yosihisa/EDAMAMEv3/PCB/EDAMAMEv3.kicad_pcb

## KiCad design PCB/EDAMAMEv3.kicad_pcb (2019-02-07)

Schematic: EDAMAMEv3.sch, EDAMAME v3

Parts:
C1, C3, C4, C7, C9, C11, C12, C13, C14: 0.1u; C_0603_1608Metric_Pad1.05x0.95mm_HandSolder
C2, C5: 2.2u; C_0603_1608Metric_Pad1.05x0.95mm_HandSolder
C6, C10: 1u; C_0603_1608Metric_Pad1.05x0.95mm_HandSolder
C8, C15, C16: 10u; C_0805_2012Metric_Pad1.15x1.40mm_HandSolder
D1, D2, D3, D4, D5: LED; LED_0603_1608Metric_Pad1.05x0.95mm_HandSolder
J1: BOOT0; SolderJumper-2_P1.3mm_Open_RoundedPad1.0x1.5mm
J2: Debug; STlink
J3: FLIGHT_PIN; PinHeader_1x02_P2.54mm_Horizontal
J4: WiFi; ZUNDA_WIRELESS
J5: C1098; Pin_Header_Straight_1x04_Pitch2.00mm
P1: LiPo1; JST_EH_S02B-EH_1x02_P2.50mm_Horizontal
P2: LiPo2; JST_EH_S02B-EH_1x02_P2.50mm_Horizontal
P3: CHARGE; JST_EH_B03B-EH-A_1x03_P2.50mm_Vertical
P4: MOTOR_R; JST_EH_B02B-EH-A_1x02_P2.50mm_Vertical
P5: MOTOR_L; JST_EH_B02B-EH-A_1x02_P2.50mm_Vertical
P6: NICHROME; TerminalBlock_MetzConnect_Type101_RT01602HBWC_1x02_P5.08mm_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
Q1: 2SC2712; SOT-23
Q2: FDS4675; SOIC-8_3.9x4.9mm_P1.27mm
R1, R3: 10; R_0603_1608Metric_Pad1.05x0.95mm_HandSolder
R2: 10m; R_2512_6332Metric_Pad1.52x3.35mm_HandSolder
R4, R5, R6, R7, R19: 1k; R_0603_1608Metric_Pad1.05x0.95mm_HandSolder
R8, R18: 10k; R_0603_1608Metric_Pad1.05x0.95mm_HandSolder
R9, R10: 2.2k; R_0603_1608Metric_Pad1.05x0.95mm_HandSolder
R11: 47; R_0603_1608Metric_Pad1.05x0.95mm_HandSolder
R12, R13, R14, R15, R16: 22K; R_0603_1608Metric_Pad1.05x0.95mm_HandSolder
R17: 100; R_0603_1608Metric_Pad1.05x0.95mm_HandSolder
SW1: POWER; SS-12D01-VG4
U1: ADP3338AKCZ-3.3; SOT-223-3_TabPin2
U2: MCP1703AT-3302E/CB; SOT-23
U3: STM32F767VITx; LQFP-100_14x14mm_P0.5mm
U4: INA226; MSOP-10_3x3mm_P0.5mm
U5: MPU-9250; QFN-24_3x3mm_P0.4mm
U6: GYSFDMAXB
U7: microSD; microSD_HC_Hirose_DM3AT-SF-PEJM5
U8, U9: BD6231F; SOIC-8_3.9x4.9mm_P1.27mm

Connections:
+3V3: C3.1, C8.1, C9.1, C12.2, C13.1, J4.3, J5.1, R8.1, R9.2, R10.2, R12.2, R13.2, R14.2, R15.2, R16.2, U1.2 (VO), U3.6, U3.11, U3.20, U3.21, U3.27, U3.50, U3.75, U3.100, U4.1, U4.2, U4.6, U5.1, U5.8, U5.9, U5.13, U5.22, U6.16 (VDD), U7.4 (VDD)
+BATT: C1.1, C15.1, C16.1, Q2.1, Q2.2, Q2.3, R2.1, R3.2, R4.2, R18.2, U1.3 (VI), U8.2 (VCC), U8.3 (VCC), U8.6 (VREF), U9.2 (VCC), U9.3 (VCC), U9.6 (VREF)
/CAMERA_RX: J5.3, U3.55
/CAMERA_TX: J5.2, U3.56
/FLIGHT_PIN: J3.2, R8.2, U3.87
/GPS_BACKUP: C10.1, U2.2 (VO), U6.14 (BATT)
/GPS_RX: U3.53, U6.3 (RX)
/GPS_TX: U3.54, U6.5 (TX)
/I2C_SCL: R9.1, U3.46, U4.5, U5.23
/I2C_SDA: R10.1, U3.47, U4.4, U5.24
/LED1: R5.2, U3.84
/LED2: R6.2, U3.85
/LED3: R7.2, U3.86
/MOTOR_LF: U3.62, U9.4 (FIN)
/MOTOR_LR: U3.61, U9.5 (RIN)
/MOTOR_RF: U3.59, U8.5 (RIN)
/MOTOR_RR: U3.60, U8.4 (FIN)
/NICHROME: R17.2, U3.35
/PC_RX: J2.1, U3.71
/PC_TX: J2.2, U3.70
/SD: U3.34, U7.10 (DET_A)
/SDIO_CK: R11.2, U3.80
/SDIO_CMD: R14.1, U3.83, U7.3 (CMD)
/SDIO_D0: R15.1, U3.65, U7.7 (DAT0)
/SDIO_D1: R16.1, U3.66, U7.8 (DAT1)
/SDIO_D2: R12.1, U3.78, U7.1 (DAT2)
/SDIO_D3: R13.1, U3.79, U7.2 (DAT3/CD)
/SWCLK: J2.3, U3.76
/SWDIO: J2.4, U3.72
/WiFi_RX: J4.1, U3.52
/WiFi_TX: J4.2, U3.51
GND: C1.2, C2.2, C3.2, C4.2, C5.2, C6.2, C7.2, C8.2, C9.2, C10.2, C12.1, C13.2, C14.2, C15.2, C16.2, D1.1 (K), D2.1 (K), D3.1 (K), D4.1 (K), D5.1 (K), J1.1, J2.5, J3.1, J4.4, J5.4, P2.2, P3.3, P6.2, Q1.2, U1.1 (GND), U2.1 (GND), U3.10, U3.19, U3.26, U3.49, U3.74, U3.99, U4.7, U5.18, U5.20, U6.1 (GND), U6.2 (GND), U6.7 (GND), U6.10 (GND), U6.12 (GND), U6.19 (GND), U6.20 (GND), U7.6 (VSS), U7.9 (DET_B), U8.8 (GND), U9.8 (GND)
unnamed: C2.1, C4.1, U3.48
unnamed: C5.1, C7.1, U3.73
unnamed: C6.1, P1.1, P3.1, SW1.2 (B), U2.3 (VI)
unnamed: C11.1, R3.1, U4.9
unnamed: C11.2, R1.1, U4.10
unnamed: C14.1, U5.10
unnamed: D1.2 (A), R4.1
unnamed: D2.2 (A), R5.1
unnamed: D3.2 (A), R6.1
unnamed: D4.2 (A), R7.1
unnamed: D5.2 (A), R19.1
unnamed: J1.2, U3.94
unnamed: P1.2, P2.1, P3.2
unnamed: P4.1, U8.1 (OUT1)
unnamed: P4.2, U8.7 (OUT2)
unnamed: P5.1, U9.1 (OUT1)
unnamed: P5.2, U9.7 (OUT2)
unnamed: P6.1, Q2.5, Q2.6, Q2.7, Q2.8, R19.2
unnamed: Q1.1, R17.1
unnamed: Q1.3, Q2.4, R18.1
unnamed: R1.2, R2.2, SW1.3 (C), U4.8
unnamed: R11.1, U7.5 (CLK)

Notes on the sheet:
NJM2391DL1 3.3V 1.0A
3.3V 250mA For GPS backup power

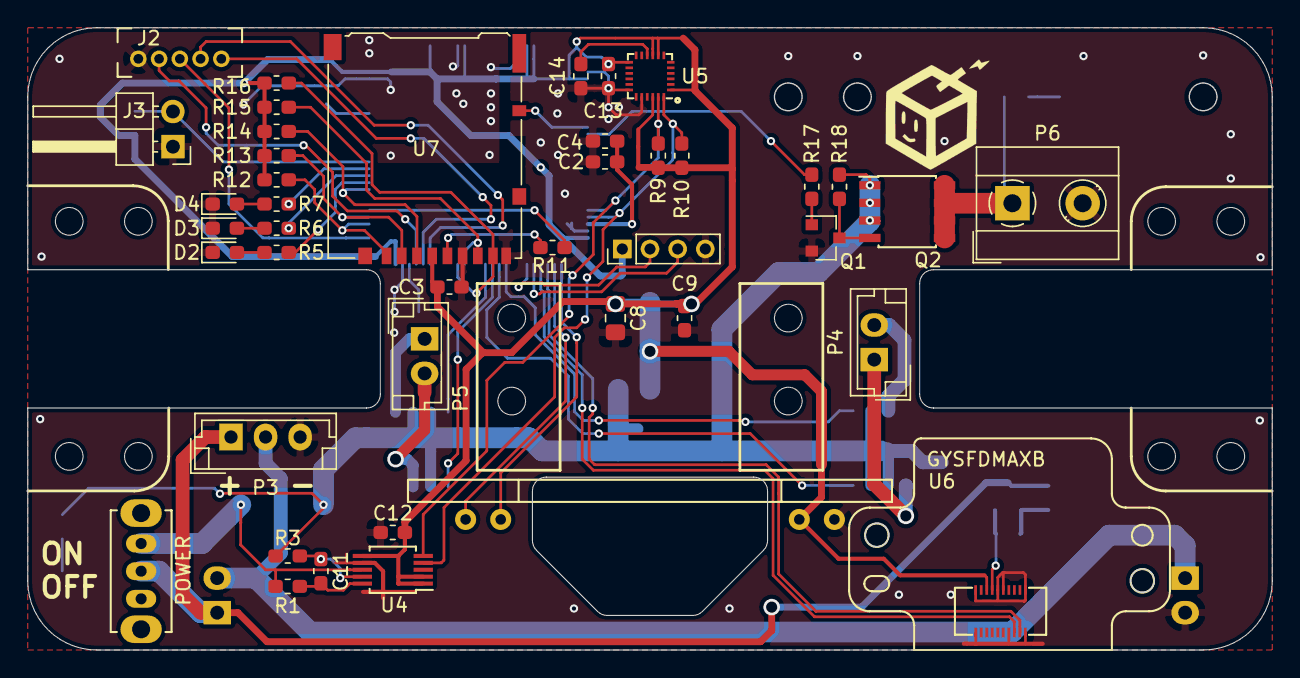
[picture p1: board EDAMAMEv3.kicad_pcb from above]

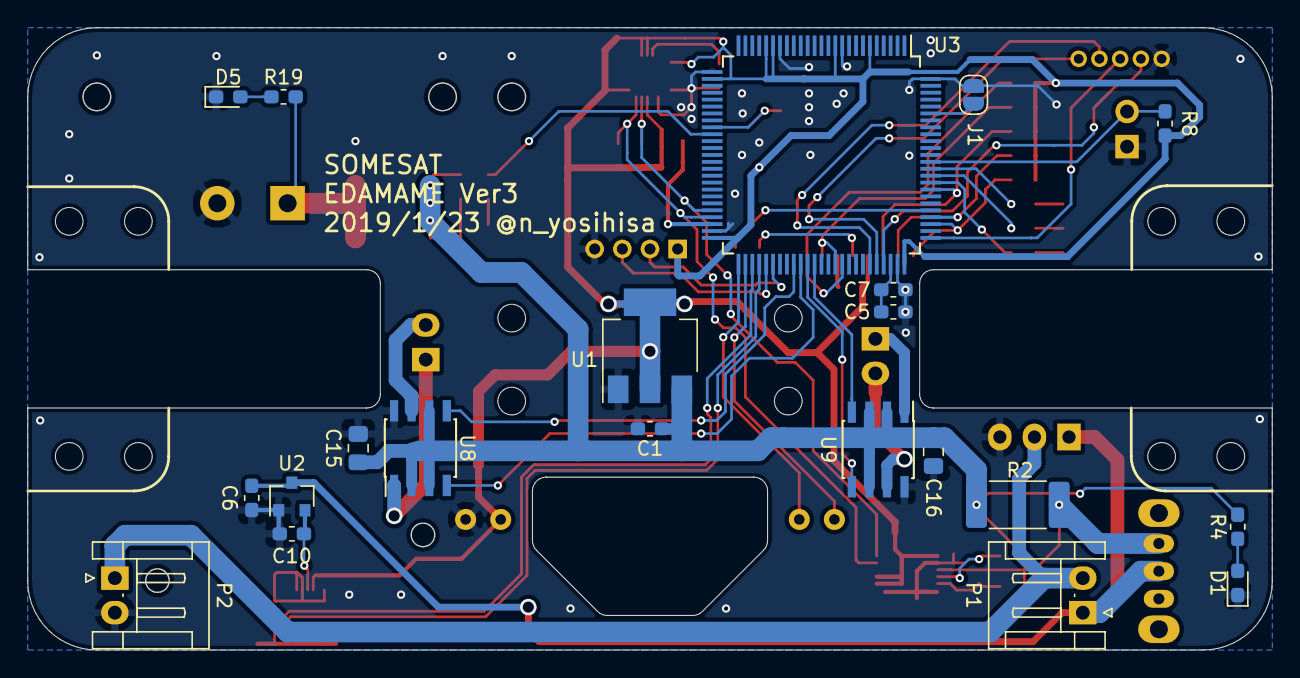
[picture p2: board EDAMAMEv3.kicad_pcb from below]

Board: 2 copper layers, 90.0 x 45.0 mm, 63 parts (21 on the bottom side), 54 nets.
