yosihisa/EDAMAMEv3/src_BBM/Src/main.c

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

/* Includes ------------------------------------------------------------------*/
#include "main.h"
#include "fatfs.h"

/* USER CODE BEGIN Includes */
#include "edamame.h"
/* USER CODE END Includes */


JPEG_HandleTypeDef hjpeg;

SD_HandleTypeDef hsd1;

TIM_HandleTypeDef htim2;

UART_HandleTypeDef huart4;
UART_HandleTypeDef huart3;

/* USER CODE BEGIN PV */
// 標準出力をUART1へ
#ifdef __GNUC__
#define PUTCHAR_PROTOTYPE int __io_putchar(int ch)
#else
#define PUTCHAR_PROTOTYPE int fputc(int ch, FILE *f)
#endif /* __GNUC__ */
void __io_putchar(uint8_t ch) {
	HAL_UART_Transmit(&huart3, &ch, 1, 1);
}
/* USER CODE END PV */

void SystemClock_Config(void);
static void MX_GPIO_Init(void);
static void MX_USART3_UART_Init(void);
static void MX_SDMMC1_SD_Init(void);
static void MX_JPEG_Init(void);
static void MX_UART4_Init(void);
static void MX_TIM2_Init(void);
/**
  * @brief  The application entry point.
  * @retval int
  */
int main(void)
{
  /* Enable I-Cache---------------------------------------------------------*/
  SCB_EnableICache();

  /* Enable D-Cache---------------------------------------------------------*/
  SCB_EnableDCache();

  /* MCU Configuration--------------------------------------------------------*/

  /* Reset of all peripherals, Initializes the Flash interface and the Systick. */
  HAL_Init();

  /* Configure the system clock */
  SystemClock_Config();

  /* Initialize all configured peripherals */
  MX_GPIO_Init();
  MX_USART3_UART_Init();
  MX_SDMMC1_SD_Init();
  MX_FATFS_Init();
  MX_JPEG_Init();
  MX_UART4_Init();
  MX_TIM2_Init();
  /* USER CODE BEGIN 2 */

	HAL_TIM_Base_Start_IT(&htim2);

	//SDカード

	printf("Hello SD test.\n");
	FRESULT res_fs;
	FATFS fs;
	FIL testFile;
	DIR dir;
	char buf[128];
	int ret;
	const int MAX_DIR = 100;
	unsigned int testBytes;

	uint32_t data_size;
	uint8_t path[13] = "test.txt";

	do {
		res_fs = f_mount(&fs, "", 1);
		if (res_fs != FR_OK) {
			printf("f_mount() : error %u\n", res_fs);
		}

		res_fs = f_opendir(&dir, "");
		if (res_fs != FR_OK) {
			printf("f_opendir() : error %u\n", res_fs);
		}
		HAL_Delay(800);
	} while (res_fs != FR_OK);

	res_fs = f_open(&testFile, (char*)path, FA_WRITE | FA_CREATE_ALWAYS);
	printf("f_open:%d \r\n",res_fs);

	uint8_t testBuffer[16] = "SD write success";
	res_fs = f_write(&testFile, testBuffer, 16, &testBytes);
	printf("f_write:%d \r\n",res_fs);

	res_fs = f_close(&testFile);
	printf("f_close:%d \r\n",res_fs);



	myCansat cansat;
	//カメラ初期化
	printf("Hello C1098 test.\n");

	CAMERARESULT camrea_res;
	JDEC jdec;
	JRESULT jpeg_res;
	cansat.camera.uart_port = &huart4;
	cansat.camera.packet_size = 256;
	cansat.camera.baudrate = 460800;
	cansat.camera.resolution = QVGA;

	camrea_res = camera_init(&cansat.camera);

	printf("camera_Init %d\n", camrea_res);


	uint32_t time,loop_t;
  /* USER CODE END 2 */

  /* Infinite loop */
  /* USER CODE BEGIN WHILE */
	while (1)
	{
    /* USER CODE END WHILE */

    /* USER CODE BEGIN 3 */

		HAL_GPIO_WritePin(LD1_GPIO_Port,LD1_Pin,GPIO_PIN_SET);
		HAL_GPIO_WritePin(LD2_GPIO_Port,LD2_Pin,GPIO_PIN_SET);
		HAL_GPIO_WritePin(LD3_GPIO_Port,LD3_Pin,GPIO_PIN_SET);
		loop_t = 0;
		//撮影
		TIM2->CNT = 0;
		while(snap_shot(&cansat.camera) != CAMERA_OK);
		time = TIM2->CNT;
		loop_t += time;
		printf("\n[%6.1fms] snap_shot\n", 0.1*time);

		//写真を転送
		TIM2->CNT = 0;
		camrea_res = get_picture(&cansat.camera, &cansat.jpeg.io.jpeg_data, MAX_SIZE, &cansat.jpeg.data_size);
		time = TIM2->CNT;
		loop_t += time;
		printf("[%6.1fms] get_picture   : %d %5.3fkB \n", 0.1*time,camrea_res,0.001*cansat.jpeg.data_size);

		//JPEGデコード
		TIM2->CNT = 0;
		uint8_t work[3100];
		cansat.jpeg.io.jpeg_data_seek = 0;
		jpeg_res = jd_prepare(&jdec, in_func, work, 3100, &cansat.jpeg.io);
		memset(&cansat.jpeg.io.RED_bool, 0, sizeof(&cansat.jpeg.io.RED_bool));
		time = TIM2->CNT;
		loop_t += time;
		printf("[%6.1fms] jd_prepare    : %d\n", 0.1*time,jpeg_res);


		if (jpeg_res == JDR_OK) {
			//デコード開始
			TIM2->CNT = 0;
			jpeg_res = jd_decomp(&jdec, out_func, 0);
			time = TIM2->CNT;
			loop_t += time;
			printf("[%6.1fms] jd_decomp     : %d\n", 0.1*time,jpeg_res);
			if (jpeg_res == JDR_OK) {

				//重心計算
				TIM2->CNT = 0;
				uint16_t xc = 0, yc = 0, s = 0;
				for (UINT h = 0; h < jdec.height; h++) {
					for (UINT w = 0; w < jdec.width; w++) {
						if ((cansat.jpeg.io.RED_bool[h][w / 8] & (0b10000000 >> (w % 8))) != 0) {
							xc += w;
							yc += h;
							s++;
						}
					}
				}
				time = TIM2->CNT;
				loop_t += time;
				printf("[%6.1fms] centroid calc : %d x=%3d y=%3d s=%4d\n", 0.1*time,jpeg_res,xc/s,yc/s,s);
			}
		}
		printf("--------------------------\n");
		printf("[%6.1fms] Total\n", 0.1*loop_t);
		HAL_GPIO_WritePin(LD1_GPIO_Port,LD1_Pin,GPIO_PIN_RESET);
		HAL_GPIO_WritePin(LD2_GPIO_Port,LD2_Pin,GPIO_PIN_RESET);
		HAL_GPIO_WritePin(LD3_GPIO_Port,LD3_Pin,GPIO_PIN_RESET);

		while(TIM2->CNT + loop_t <20000);
	}
  /* USER CODE END 3 */
}

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
