yosihisa/EDAMAMEv3/src/EDAMAME_v3.ioc

Mcu.UserName=STM32F767VITx
PA11.Signal=UART4_RX
PA12.Signal=UART4_TX
PA13.Signal=SYS_JTMS-SWDIO
PA14.Signal=SYS_JTCK-SWCLK
PB0.GPIO_Label=SD
PB0.Signal=GPIO_Input
PB1.Signal=S_TIM3_CH4
PB10.Signal=I2C2_SCL
PB11.Signal=I2C2_SDA
PB12.Signal=UART5_RX
PB13.Signal=UART5_TX
PB14.Signal=USART1_TX
PB15.Signal=USART1_RX
PC10.Signal=SDMMC1_D2
PC11.Signal=SDMMC1_D3
PC12.Signal=SDMMC1_CK
PC8.Signal=SDMMC1_D0
PC9.Signal=SDMMC1_D1
PD12.Signal=S_TIM4_CH1
PD13.Signal=S_TIM4_CH2
PD14.Signal=S_TIM4_CH3
PD15.Signal=S_TIM4_CH4
PD2.Signal=SDMMC1_CMD
PD3.GPIO_Label=LED3
PD3.Signal=GPIO_Output
PD4.GPIO_Label=LED2
PD4.Signal=GPIO_Output
PD5.GPIO_Label=LED1
PD5.Signal=GPIO_Output
PD6.GPIO_Label=flightPin
PD6.Signal=GPIO_Input
PD8.Signal=USART3_TX
PD9.Signal=USART3_RX
