yosihisa/EDAMAMEv3/(notices)

Notices in the files:
src_BBM/Src/main.c:
Copyright (c) 2019 STMicroelectronics International N.V.
All rights reserved.
(C) COPYRIGHT STMicroelectronics *****END OF FILE
